RobStride/EDULITE_A3/ACTIVATE_XBOX_CONTROLLER.md

# 激活已连接的Xbox手柄

## ✅ 当前状态

您的Xbox手柄已通过蓝牙成功连接（电量31%），现在需要激活joystick接口。

## 🔧 激活步骤

请在终端中依次执行以下命令：

### 1. 重新加载joydev模块

```bash
sudo rmmod joydev
sudo modprobe joydev
```

### 2. 激活手柄（按任意按钮）

**按下Xbox手柄上的任意按钮**（如A按钮或摇杆），让系统识别它。

### 3. 验证设备

```bash
ls -l /dev/input/js*
```

应该能看到：
```
crw-rw---- 1 root input 13, 0 Jan 5 21:xx /dev/input/js0
```

## 🧪 快速测试

### 测试1：查看设备文件

```bash
# 如果看到js0，说明成功了
ls /dev/input/js0
```

### 测试2：使用ROS2 joy节点测试

```bash
cd /home/wy/RS/A3/ros2_ws
source /opt/ros/humble/setup.bash
source install/setup.bash

# 启动joy节点（使用event接口作为备选）
ros2 run joy joy_node --ros-args -p device_name:=/dev/input/js0

# 或者如果js0不存在，尝试使用event接口
# 先找出Xbox手柄的event号
cat /proc/bus/input/devices | grep -B 5 -A 5 "Xbox"
```

### 测试3：查看手柄数据

在另一个终端：
```bash
cd /home/wy/RS/A3/ros2_ws
source install/setup.bash
ros2 topic echo /joy
```

移动摇杆，应该能看到数据变化。

## 🎮 如果/dev/input/js0仍不存在

### 方案A：使用event接口

ROS2 joy节点也支持event接口。查找Xbox手柄的event设备：

```bash
# 查看所有输入设备
cat /proc/bus/input/devices

# 找到Xbox Wireless Controller对应的event号，比如event20
# 然后使用该设备
ros2 run joy joy_node --ros-args -p device_name:=/dev/input/event20 -p device_id:=0
```

### 方案B：修改launch文件使用event接口

编辑launch文件以使用event设备：

```bash
nano /home/wy/RS/A3/ros2_ws/src/el_a3_teleop/launch/simple_teleop.launch.py
```

将joy节点的参数改为：
```python
'device_name': '/dev/input/event20',  # 使用实际的event号
```

## 🚀 启动完整控制系统

手柄工作后，启动仿真系统：

```bash
cd /home/wy/RS/A3/ros2_ws
source /opt/ros/humble/setup.bash
source install/setup.bash

ros2 launch el_a3_teleop simple_teleop.launch.py
```

## 📝 一键启动脚本

我为您创建了一个启动脚本，执行：

```bash
bash /home/wy/RS/A3/scripts/start_xbox_control.sh
```

## ⚠️ 如果遇到权限问题

```bash
# 添加当前用户到input组
sudo usermod -a -G input $USER

# 注销并重新登录后生效

# 或临时修改权限
sudo chmod 666 /dev/input/js0
sudo chmod 666 /dev/input/event*
```

## 🔍 调试命令

```bash
# 查看所有输入设备
ls -la /dev/input/

# 查看设备详细信息
cat /proc/bus/input/devices

# 检查joydev模块
lsmod | grep joydev

# 查看系统日志
dmesg | tail -20
```
