RobStride/EDULITE_A3/frames_2026-01-04_16.28.14.pdf

view_frames Result

Recorded at time: 1767515294.9437292

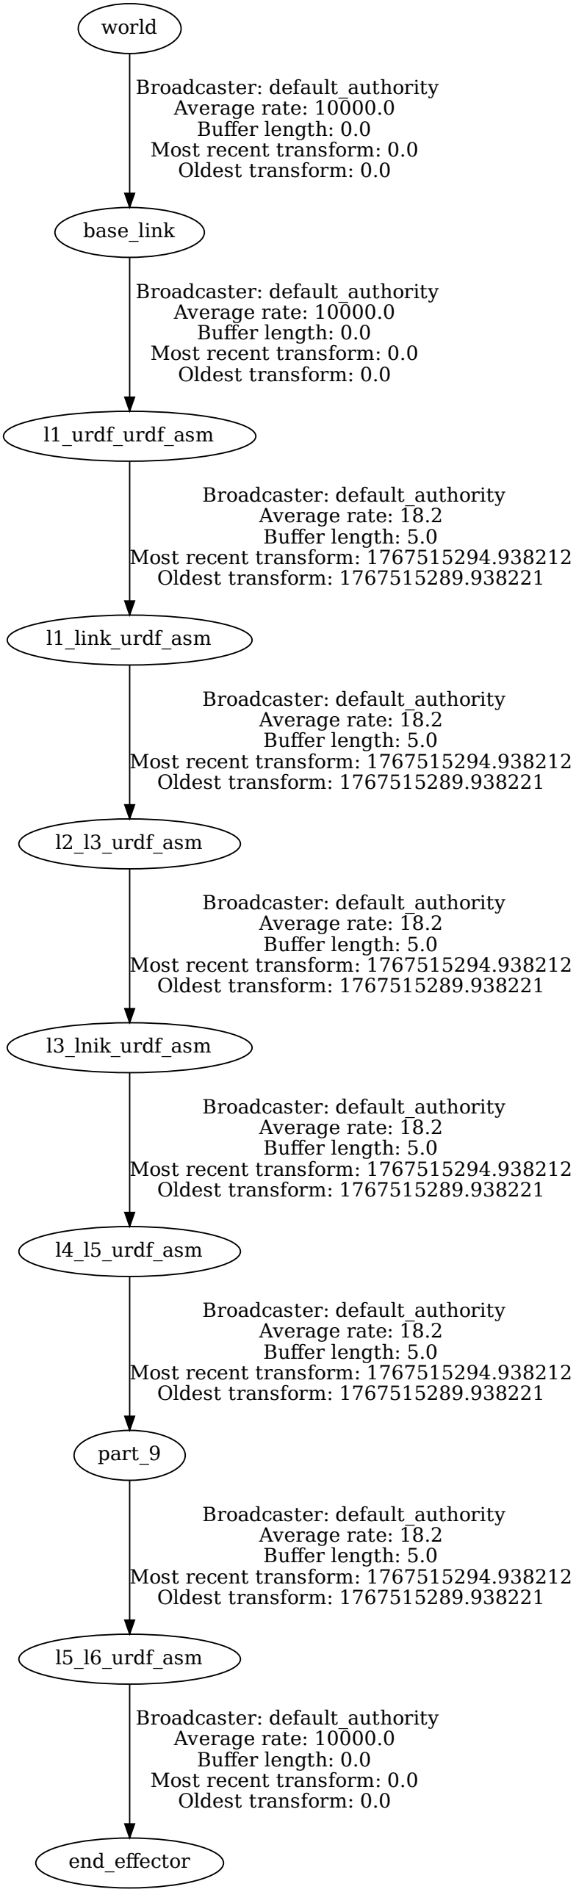
[picture p2: figure]
base_link; l1_urdf_urdf_asm; Broadcaster: default_authority Average rate: 10000.0 Buffer length: 0.0 Most recent transform: 0.0 Oldest transform: 0.0; l1_link_urdf_asm; Broadcaster: default_authority Average rate: 18.2 Buffer length: 5.0 Most recent transform: 1767515294.938212 Oldest transform: 1767515289.938221; world; l5_l6_urdf_asm; end_effector; part_9; l2_l3_urdf_asm; l3_lnik_urdf_asm; l4_l5_urdf_asm
