RobStride/EDULITE_A3/doc/image.png

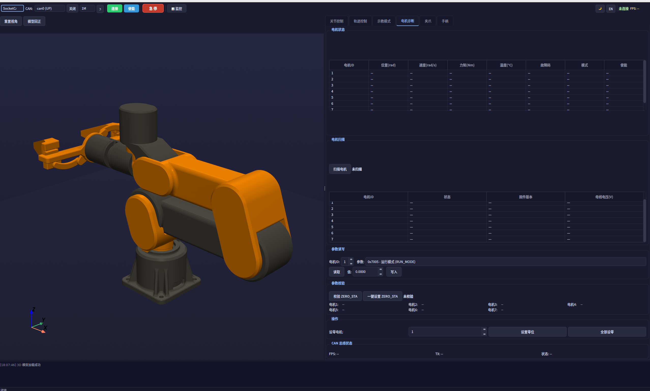
doc/image.png
