RobStride/EDULITE_A3/EL_A3_urdf/EL-A3/meshes/mainlink_back.stl

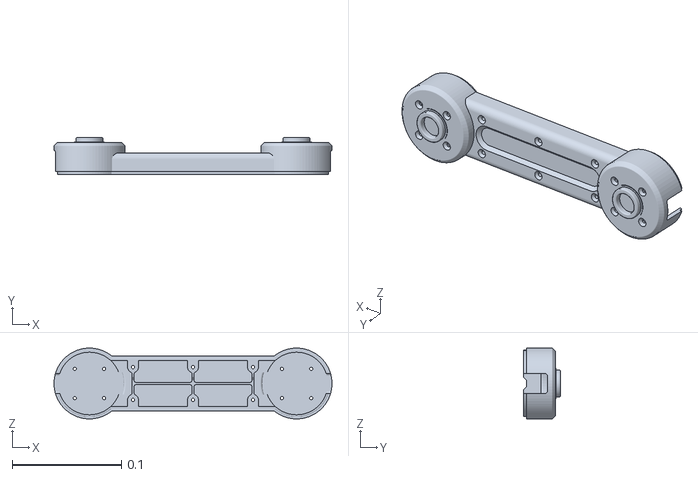
[picture p4: CAD file, 2026-02-10]
EL_A3_urdf/EL-A3/meshes/mainlink_back.stl
0.255 x 0.0338 x 0.065
