RobStride/EDULITE_A3/ros2_ws/src/el_a3_web_ui/static/urdf/meshes/mainlink_back.stl

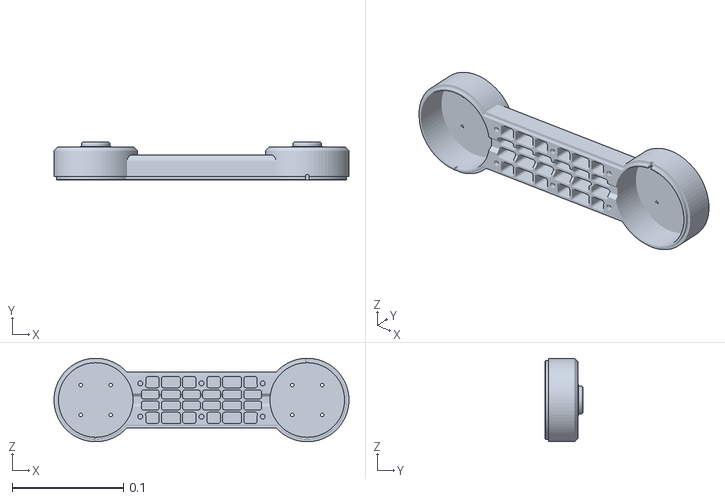
[picture p5: CAD file, 2026-02-10]
ros2_ws/src/el_a3_web_ui/static/urdf/meshes/mainlink_back.stl
0.265 x 0.0338 x 0.075
