RobStride/EDULITE_A3/EL_A3_urdf/EL-A3/meshes/mainlink_motor.stl

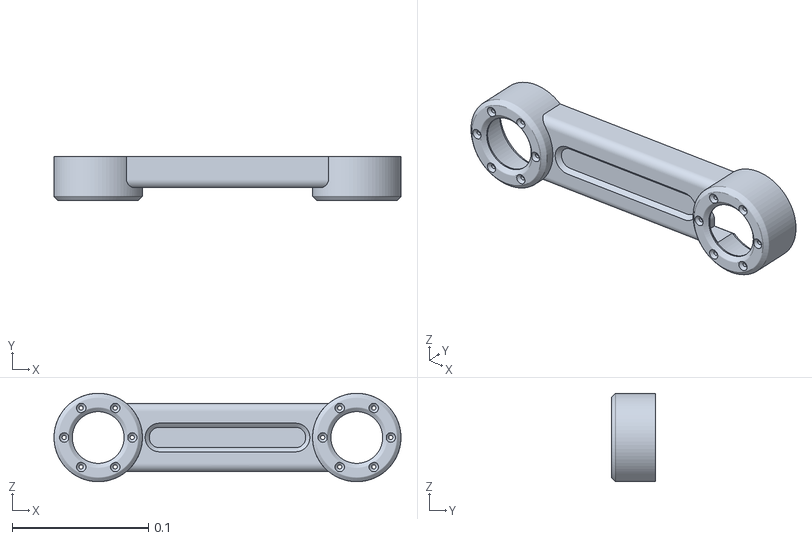
[picture p6: CAD file, 2026-02-10]
EL_A3_urdf/EL-A3/meshes/mainlink_motor.stl
0.255 x 0.0325 x 0.065
