RobStride/EDULITE_A3/EDULITE-A3/meshes/mainlink_motor.stl

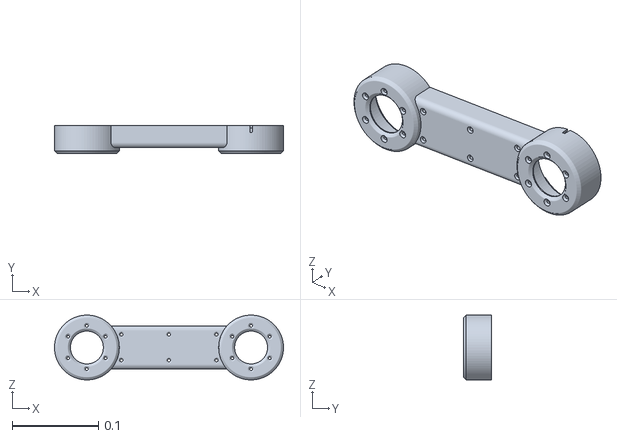
[picture p7: CAD file, 2026-02-10]
EDULITE-A3/meshes/mainlink_motor.stl
0.265 x 0.0325 x 0.075
