RobStride/EDULITE_A3/EDULITE-A3/meshes/manifold_solid_brep_39_1__2.stl

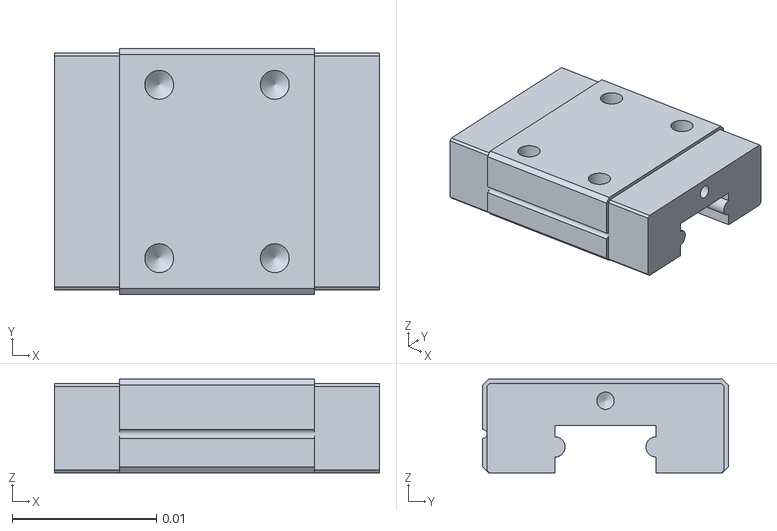
[picture p8: CAD file, 2026-02-10]
EDULITE-A3/meshes/manifold_solid_brep_39_1__2.stl
0.0225 x 0.017 x 0.0065
