RobStride/EDULITE_A3/el_a3_description/meshes/6705.stl

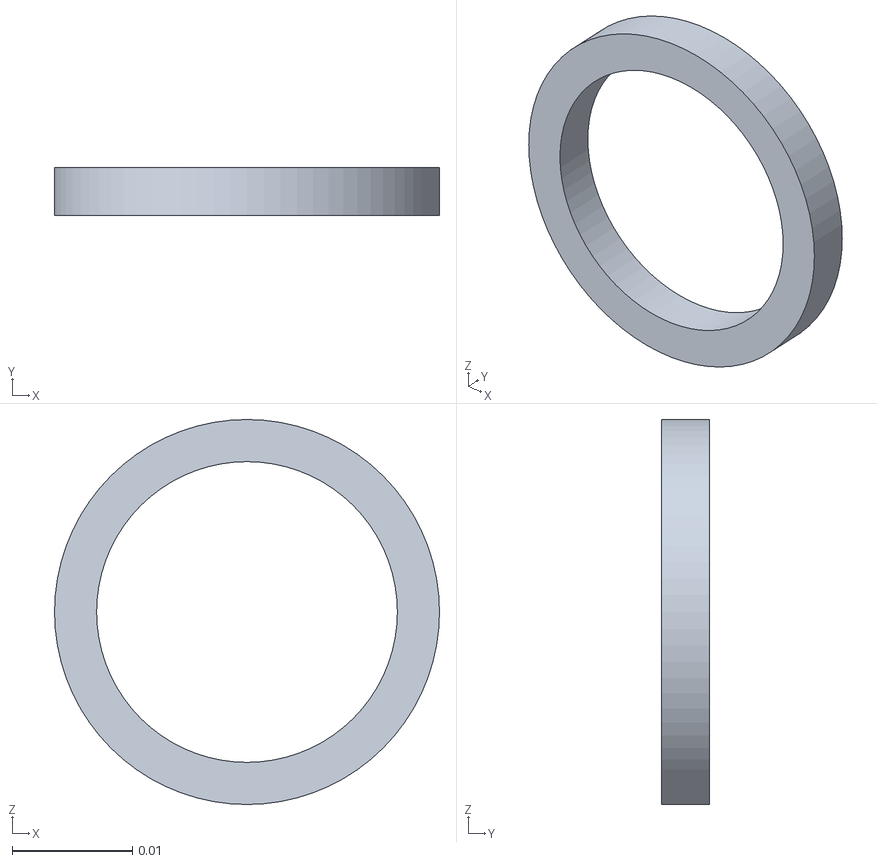
[picture p9: CAD file, 2026-02-10]
el_a3_description/meshes/6705.stl
0.032 x 0.004 x 0.032
