RobStride/EDULITE_A3/EL_A3_urdf/EL-A3/meshes/l4_l5_link_back__2.stl

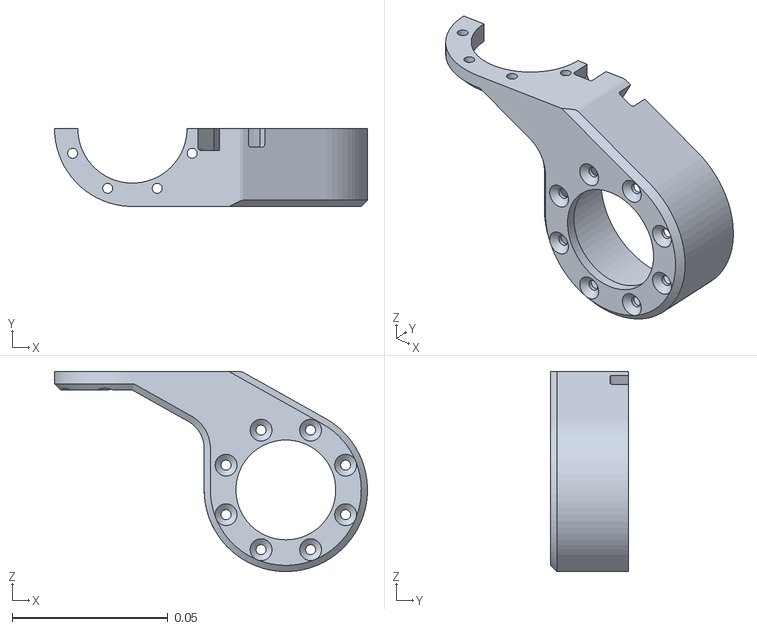
[picture p10: CAD file, 2026-02-10]
EL_A3_urdf/EL-A3/meshes/l4_l5_link_back__2.stl
0.1 x 0.025 x 0.0642
