RobStride/EDULITE_A3/ros2_ws/src/el_a3_web_ui/static/urdf/meshes/rack__30_teeth__2.stl

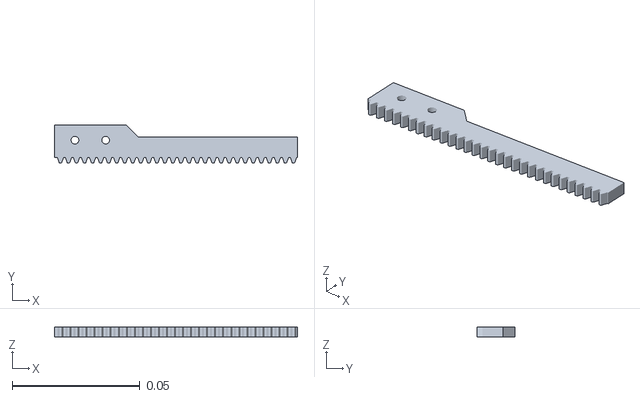
[picture p11: CAD file, 2026-02-10]
ros2_ws/src/el_a3_web_ui/static/urdf/meshes/rack__30_teeth__2.stl
0.095 x 0.015 x 0.004
