RobStride/EDULITE_A3/el_a3_description/meshes/part_9__2.stl

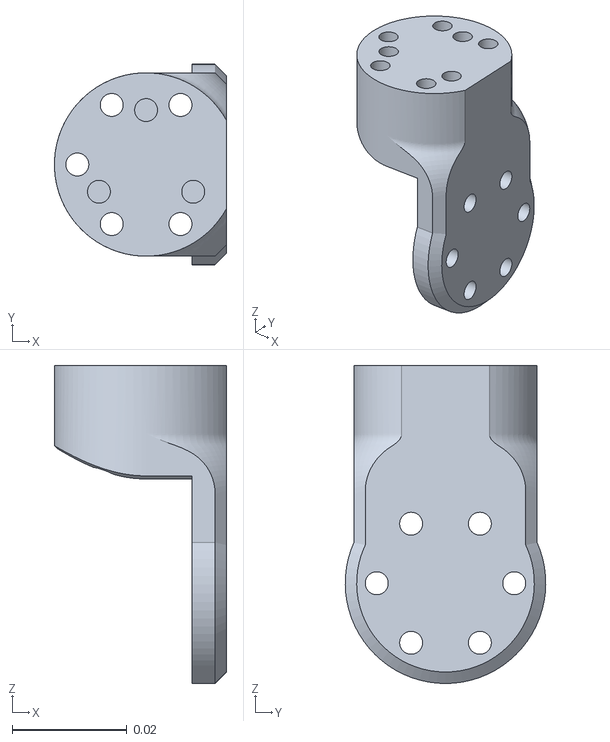
[picture p12: CAD file, 2026-02-10]
el_a3_description/meshes/part_9__2.stl
0.03 x 0.035 x 0.0555
