RobStride/EDULITE_A3/ros2_ws/src/el_a3_web_ui/static/urdf/meshes/manifold_solid_brep_40_1.stl

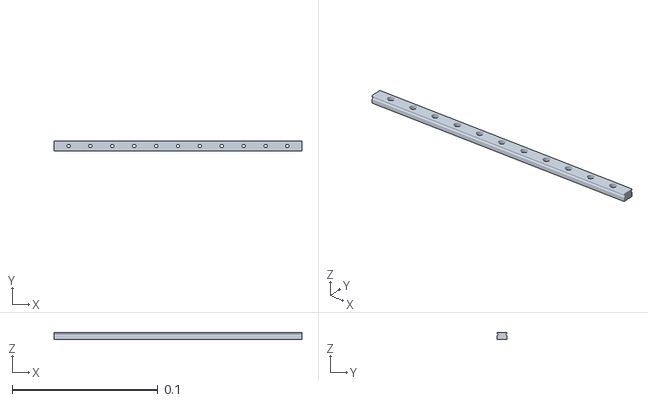
[picture p13: CAD file, 2026-02-10]
ros2_ws/src/el_a3_web_ui/static/urdf/meshes/manifold_solid_brep_40_1.stl
0.17 x 0.007 x 0.0048
