RobStride/EDULITE_A3/EDULITE-A3/meshes/part_9.stl

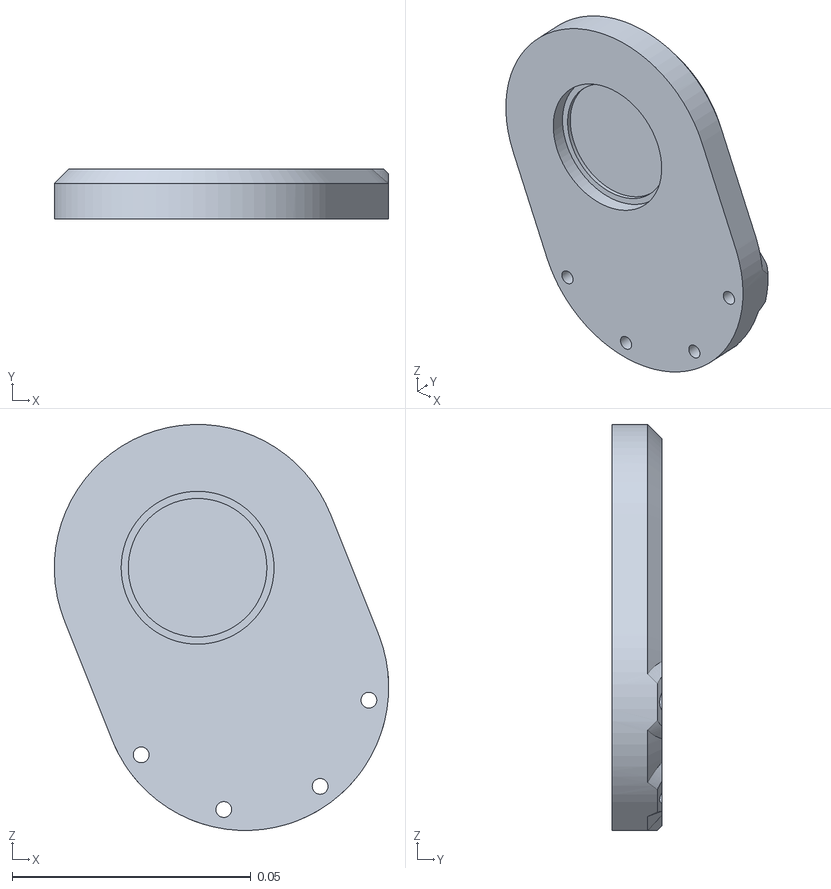
[picture p14: CAD file, 2026-02-10]
EDULITE-A3/meshes/part_9.stl
0.07 x 0.0105 x 0.085
