RobStride/EDULITE_A3/el_a3_description/meshes/small_arm_left.stl

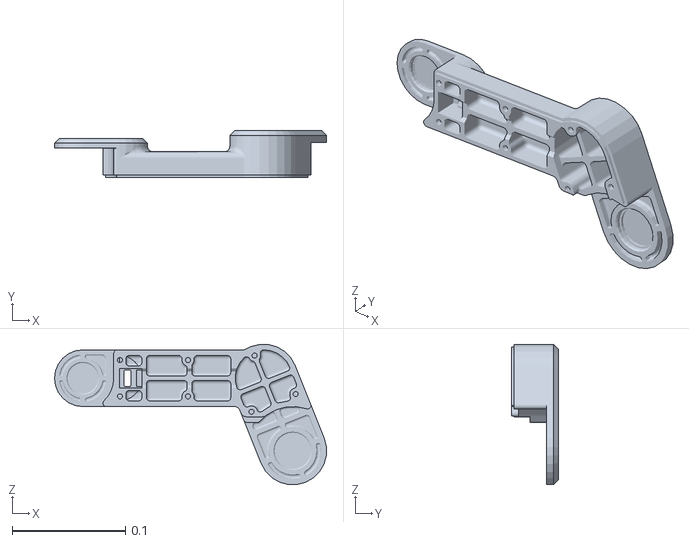
[picture p15: CAD file, 2026-02-10]
el_a3_description/meshes/small_arm_left.stl
0.24 x 0.041 x 0.124
