RobStride/EDULITE_A3/EL_A3_urdf/EL-A3/meshes/l4_link_drv.stl

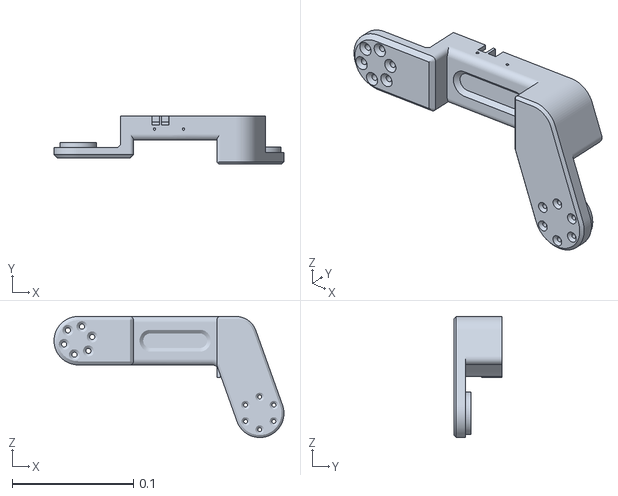
[picture p16: CAD file, 2026-02-10]
EL_A3_urdf/EL-A3/meshes/l4_link_drv.stl
0.19 x 0.04 x 0.1
