RobStride/EDULITE_A3/ros2_ws/src/el_a3_web_ui/static/urdf/meshes/el05_l5.stl

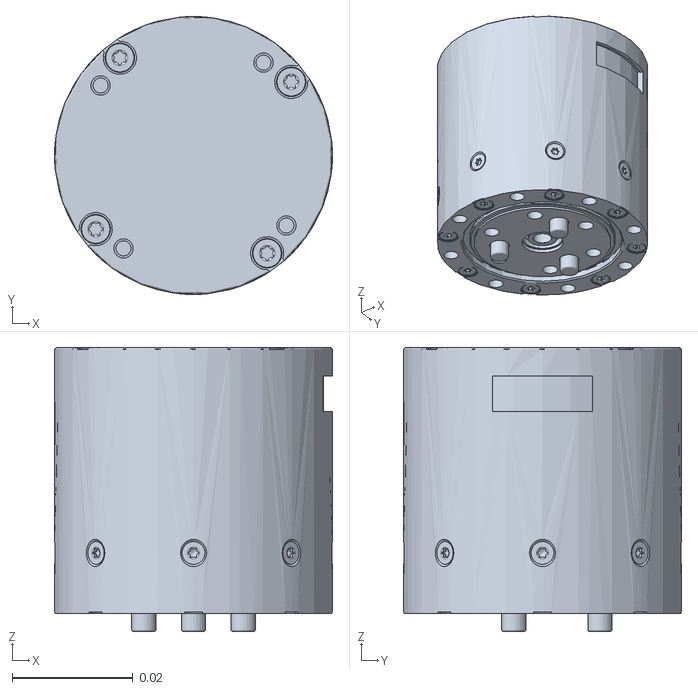
[picture p17: CAD file, 2026-02-10]
ros2_ws/src/el_a3_web_ui/static/urdf/meshes/el05_l5.stl
0.046 x 0.046 x 0.047
