RobStride/EDULITE_A3/EDULITE-A3/meshes/part_15.stl

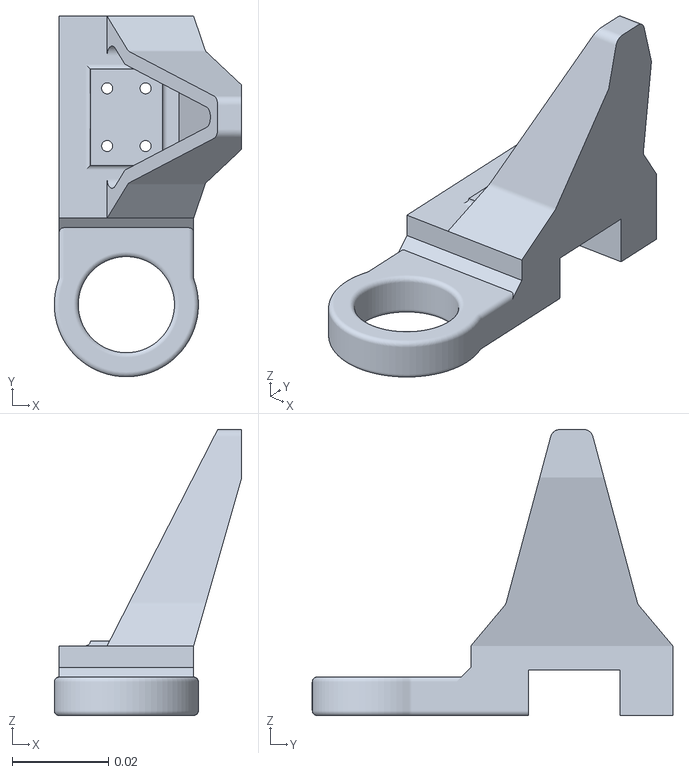
[picture p18: CAD file, 2026-02-10]
EDULITE-A3/meshes/part_15.stl
0.039 x 0.075 x 0.0595
