RobStride/EDULITE_A3/el_a3_description/meshes/l4_l5_link_back__2.stl

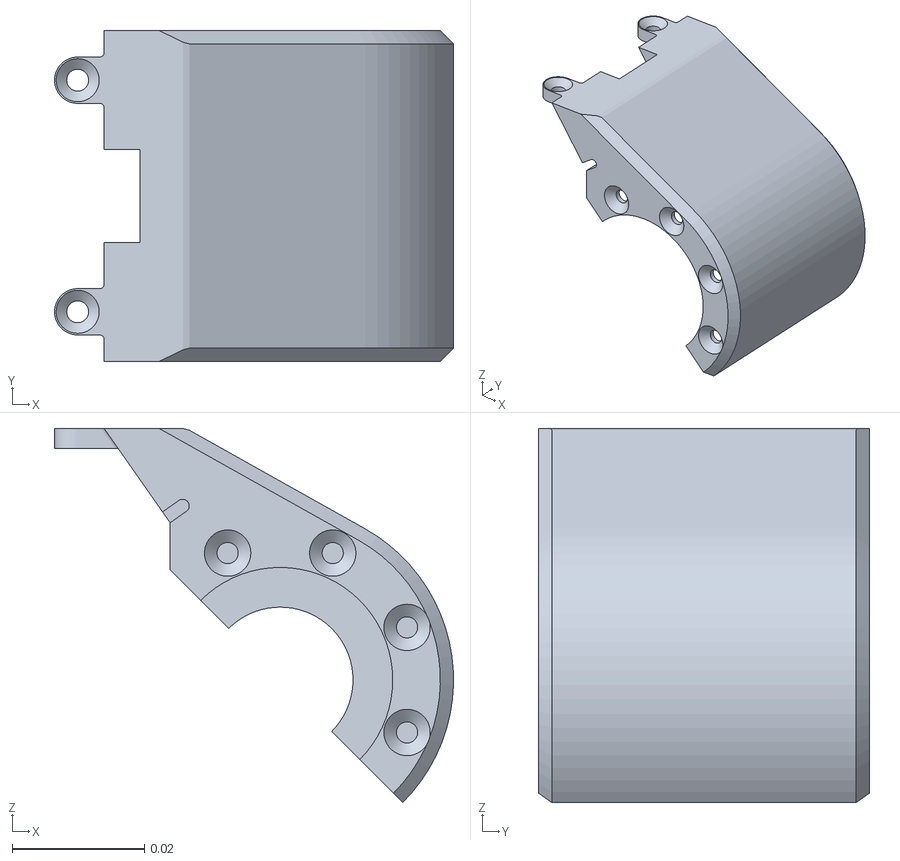
[picture p19: CAD file, 2026-02-10]
el_a3_description/meshes/l4_l5_link_back__2.stl
0.0603 x 0.05 x 0.0565
