RobStride/EDULITE_A3/EL_A3_urdf/EL-A3/meshes/l5_shake.stl

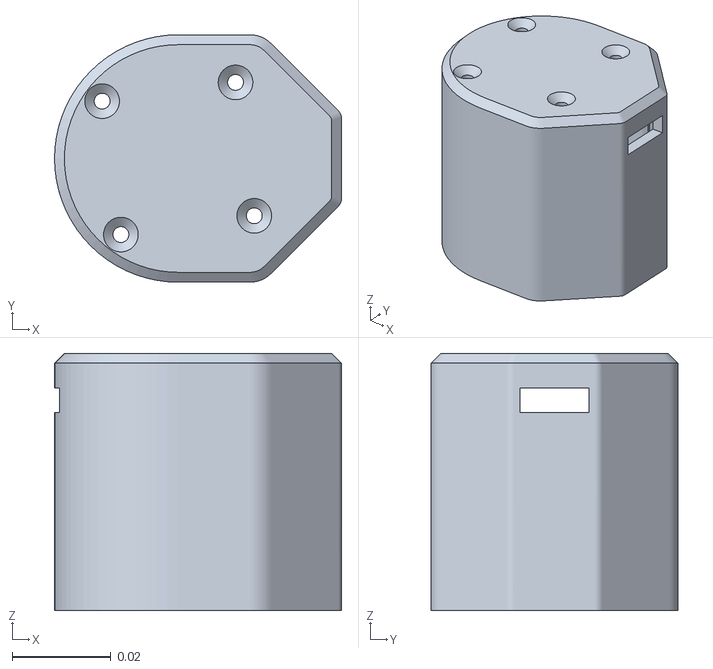
[picture p20: CAD file, 2026-02-10]
EL_A3_urdf/EL-A3/meshes/l5_shake.stl
0.058 x 0.05 x 0.052
