RobStride/EDULITE_A3/ros2_ws/src/el_a3_web_ui/static/urdf/meshes/part_4.stl

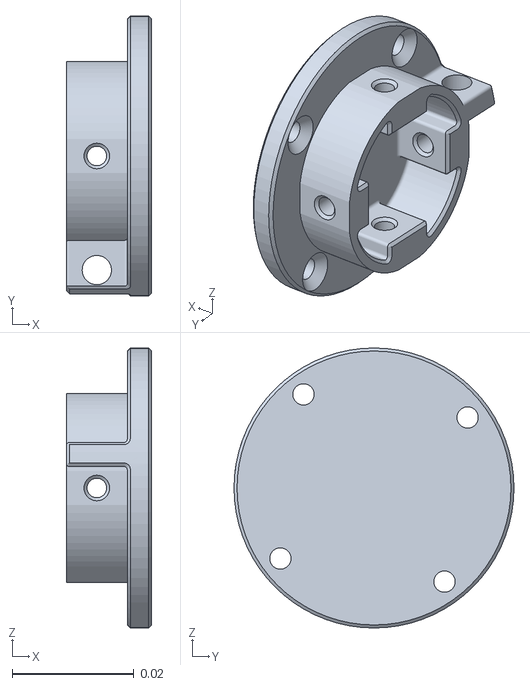
[picture p21: CAD file, 2026-02-10]
ros2_ws/src/el_a3_web_ui/static/urdf/meshes/part_4.stl
0.014 x 0.046 x 0.046
