RobStride/EDULITE_A3/el_a3_description/meshes/small_arm_right.stl

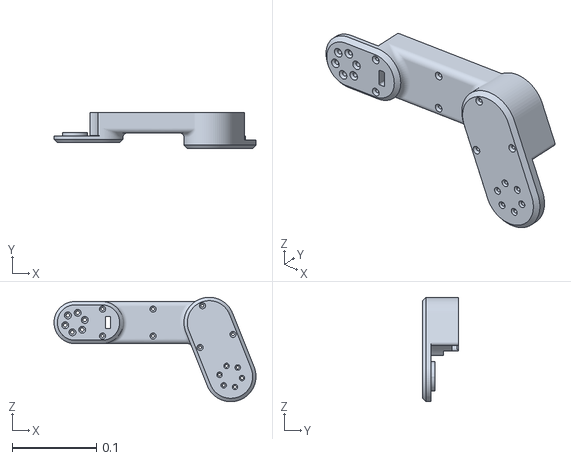
[picture p22: CAD file, 2026-02-10]
el_a3_description/meshes/small_arm_right.stl
0.24 x 0.043 x 0.124
