RobStride/EDULITE_A3/EL_A3_urdf/EL-A3/meshes/rack_str.stl

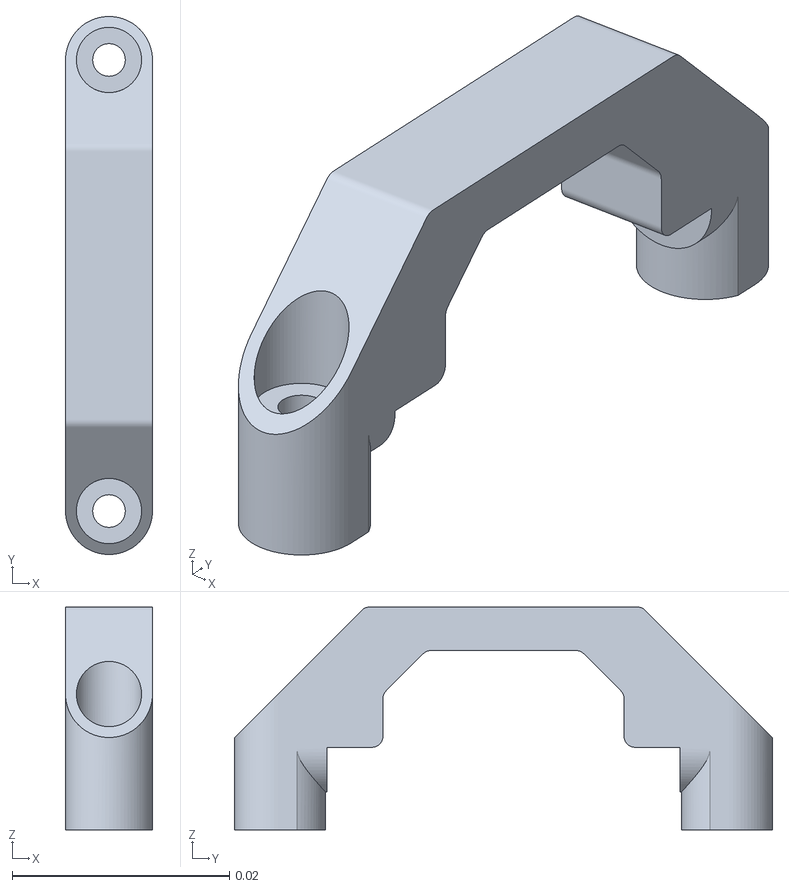
[picture p23: CAD file, 2026-02-10]
EL_A3_urdf/EL-A3/meshes/rack_str.stl
0.008 x 0.0495 x 0.0205
