RobStride/EDULITE_A3/EDULITE-A3/meshes/el05.stl

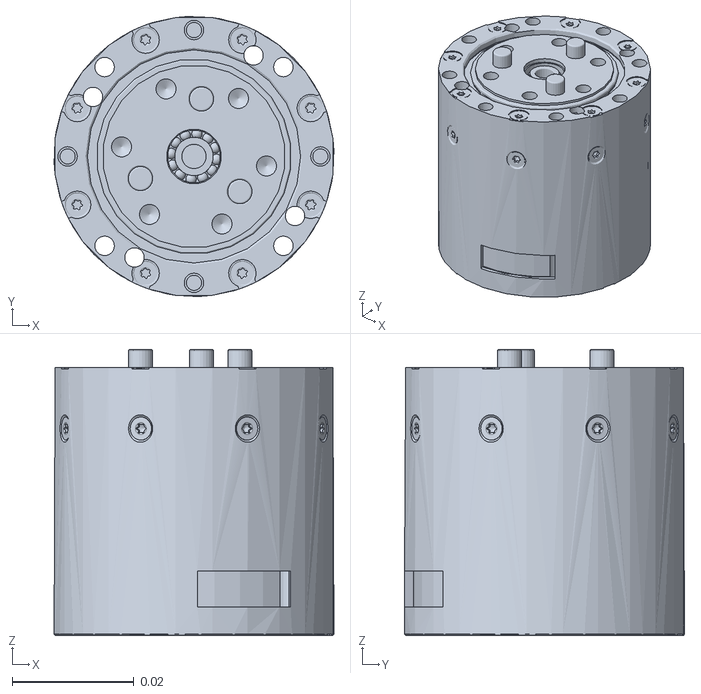
[picture p24: CAD file, 2026-02-10]
EDULITE-A3/meshes/el05.stl
0.046 x 0.046 x 0.047
