RobStride/EDULITE_A3/el_a3_description/meshes/spur_gear__14_teeth.stl

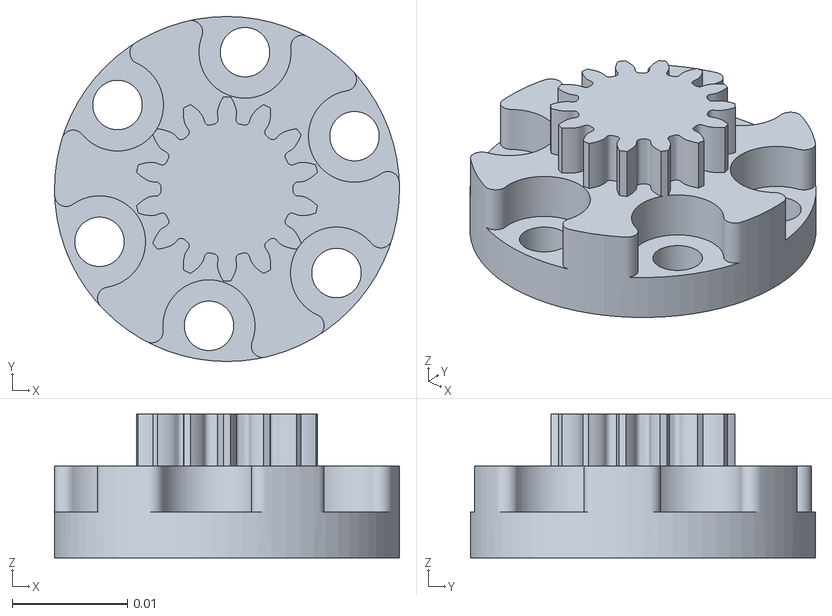
[picture p25: CAD file, 2026-02-10]
el_a3_description/meshes/spur_gear__14_teeth.stl
0.03 x 0.03 x 0.0125
