RobStride/EDULITE_A3/el_a3_description/meshes/part_8.stl

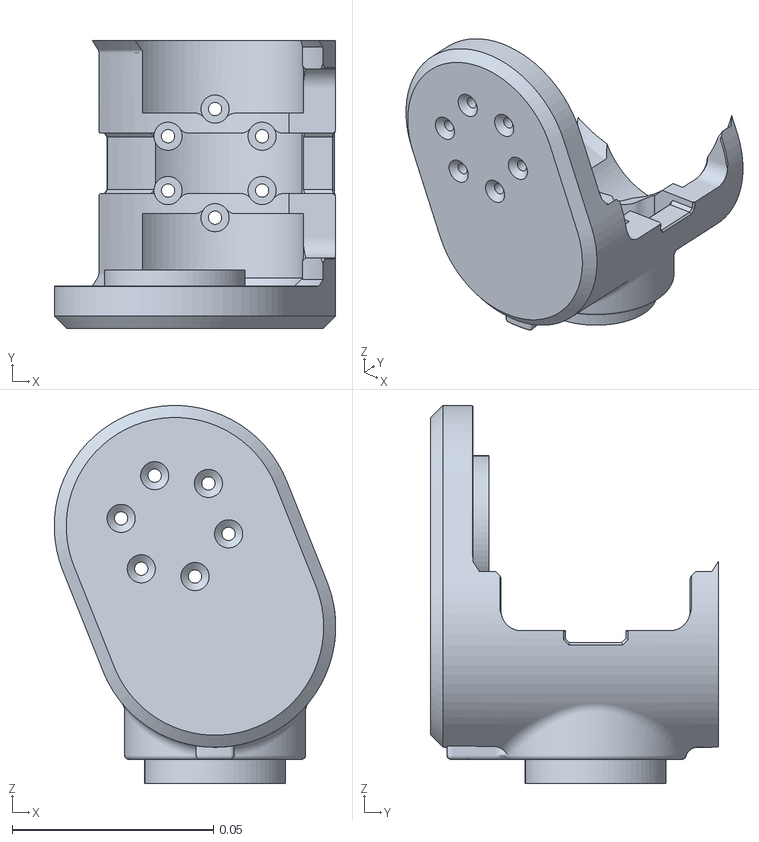
[picture p26: CAD file, 2026-02-10]
el_a3_description/meshes/part_8.stl
0.07 x 0.0715 x 0.094
