RobStride/EDULITE_A3/EDULITE-A3/meshes/rack_base.stl

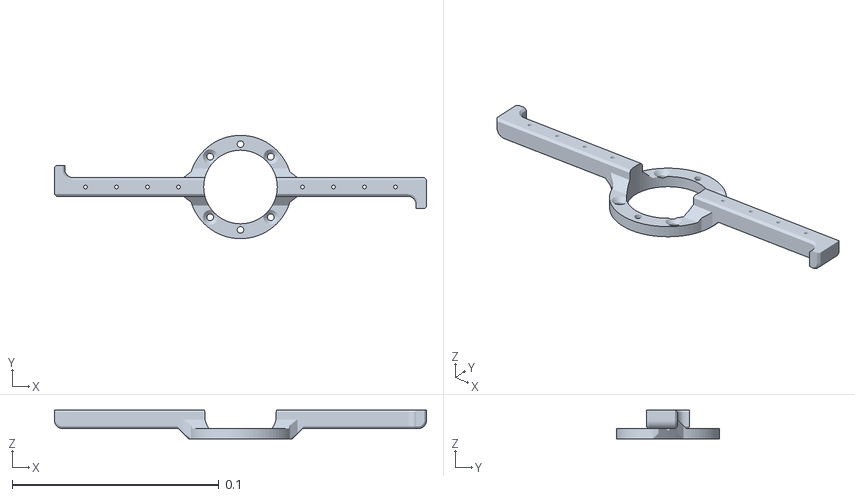
[picture p27: CAD file, 2026-02-10]
EDULITE-A3/meshes/rack_base.stl
0.18 x 0.05 x 0.014
