RobStride/EDULITE_A3/EL_A3_urdf/EL-A3/meshes/l1_link_drv.stl

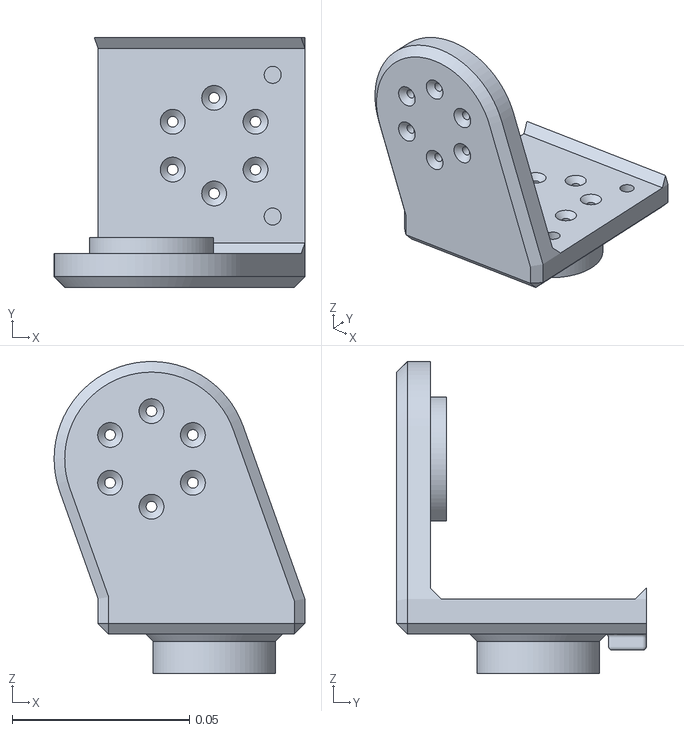
[picture p28: CAD file, 2026-02-10]
EL_A3_urdf/EL-A3/meshes/l1_link_drv.stl
0.0708 x 0.0705 x 0.0881
