RobStride/EDULITE_A3/ros2_ws/src/el_a3_web_ui/static/urdf/meshes/l4_l5_link_back.stl

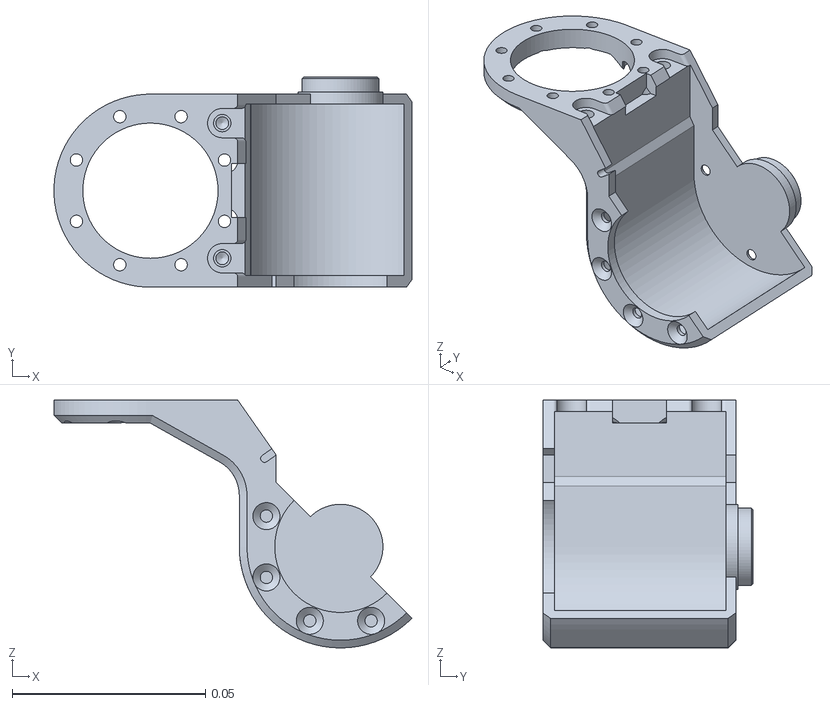
[picture p29: CAD file, 2026-02-10]
ros2_ws/src/el_a3_web_ui/static/urdf/meshes/l4_l5_link_back.stl
0.0927 x 0.0545 x 0.0642
