RobStride/EDULITE_A3/el_a3_description/meshes/part_3.stl

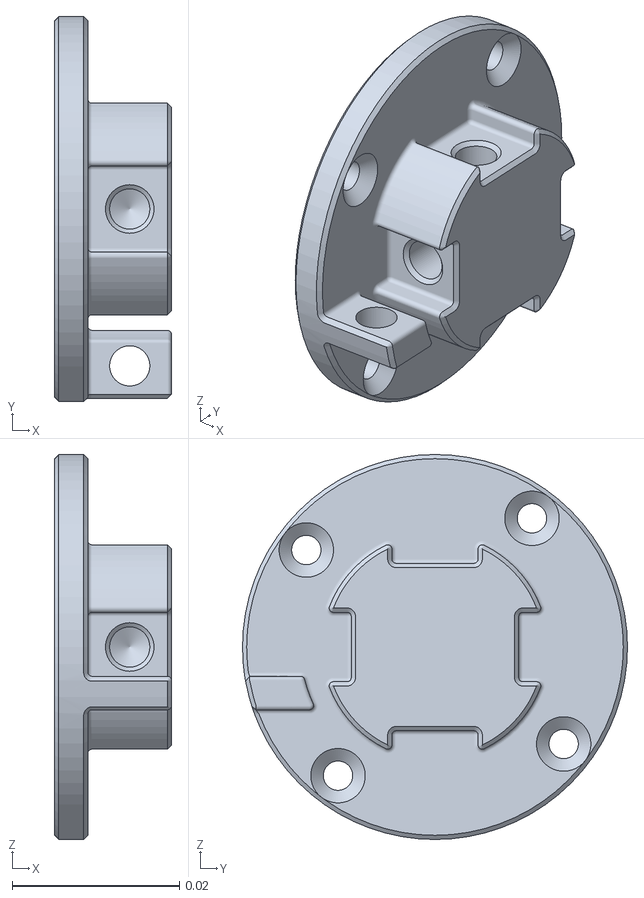
[picture p30: CAD file, 2026-02-10]
el_a3_description/meshes/part_3.stl
0.014 x 0.046 x 0.046
