RobStride/EDULITE_A3/EL_A3_urdf/EL-A3/meshes/l1_link_stop.stl

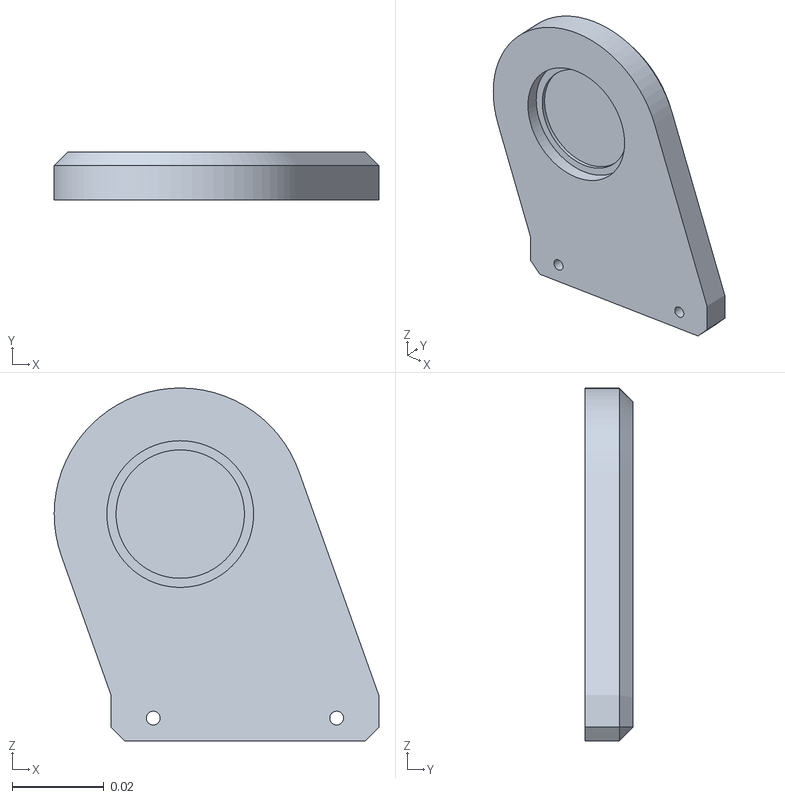
[picture p31: CAD file, 2026-02-10]
EL_A3_urdf/EL-A3/meshes/l1_link_stop.stl
0.0708 x 0.0105 x 0.077
