RobStride/EDULITE_A3/ros2_ws/src/el_a3_web_ui/static/urdf/meshes/l5_shake.stl

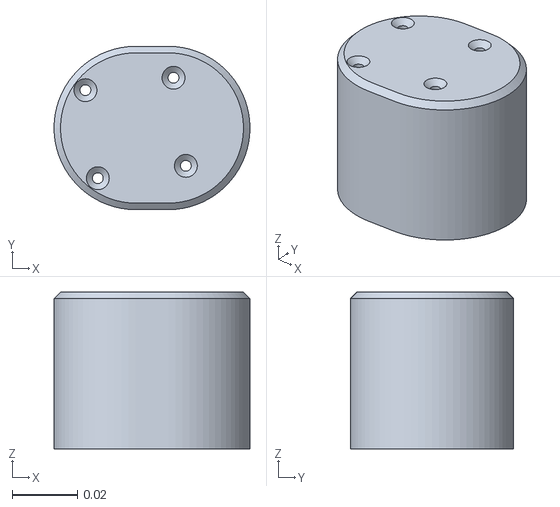
[picture p32: CAD file, 2026-02-10]
ros2_ws/src/el_a3_web_ui/static/urdf/meshes/l5_shake.stl
0.06 x 0.05 x 0.048
