RobStride/EDULITE_A3/EL_A3_urdf/EL-A3/meshes/l1_base.stl

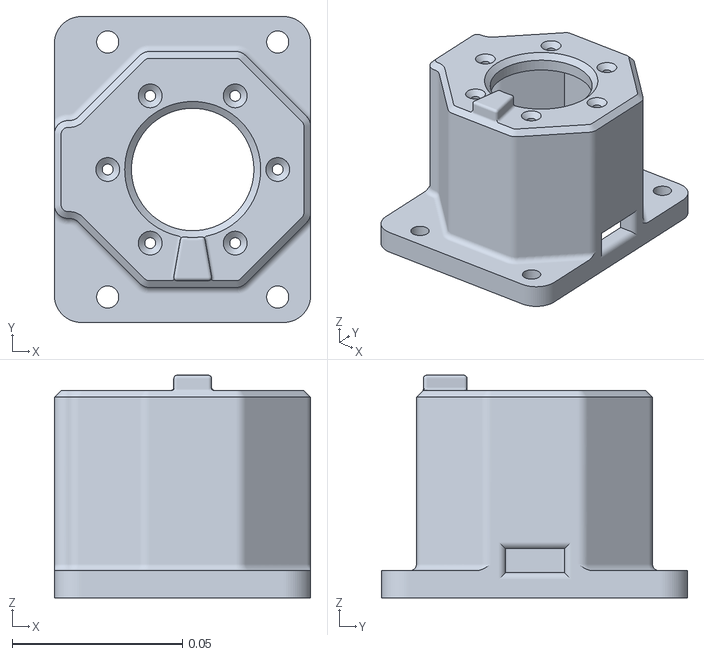
[picture p33: CAD file, 2026-02-10]
EL_A3_urdf/EL-A3/meshes/l1_base.stl
0.0754 x 0.09 x 0.0655
