RobStride/EDULITE_A3/EDULITE-A3/meshes/part_10.stl

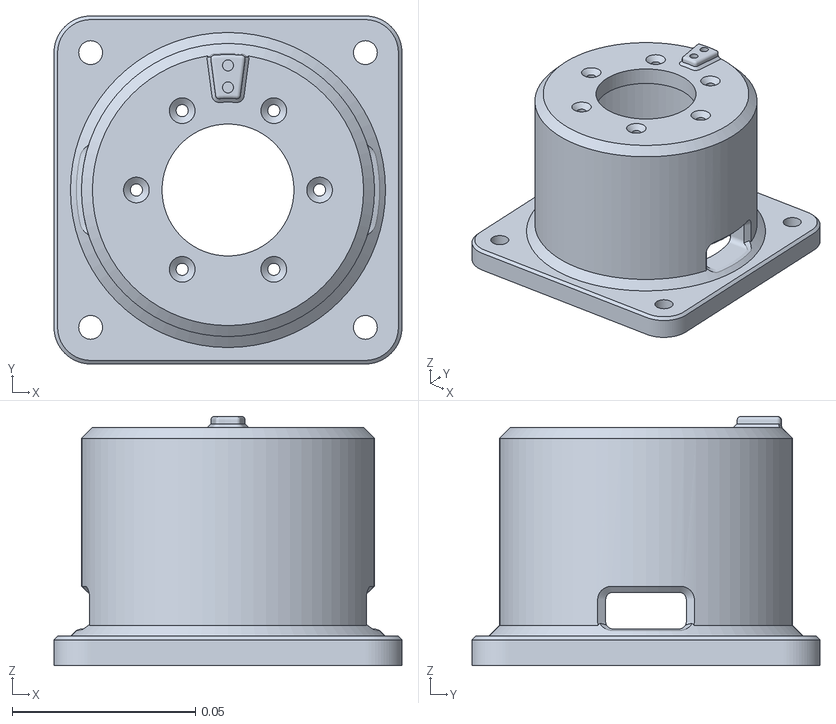
[picture p34: CAD file, 2026-02-10]
EDULITE-A3/meshes/part_10.stl
0.095 x 0.095 x 0.068
