RobStride/EDULITE_A3/EL_A3_urdf/EL-A3/meshes/part_9.stl

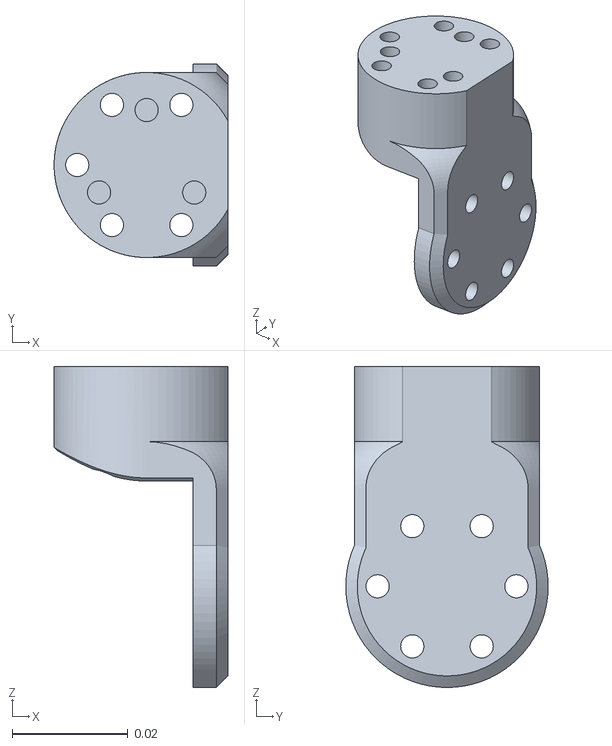
[picture p35: CAD file, 2026-02-10]
EL_A3_urdf/EL-A3/meshes/part_9.stl
0.03 x 0.035 x 0.0555
