RobStride/EDULITE_A3/EL_A3_urdf/EL-A3/meshes/l4_l5_link_back.stl

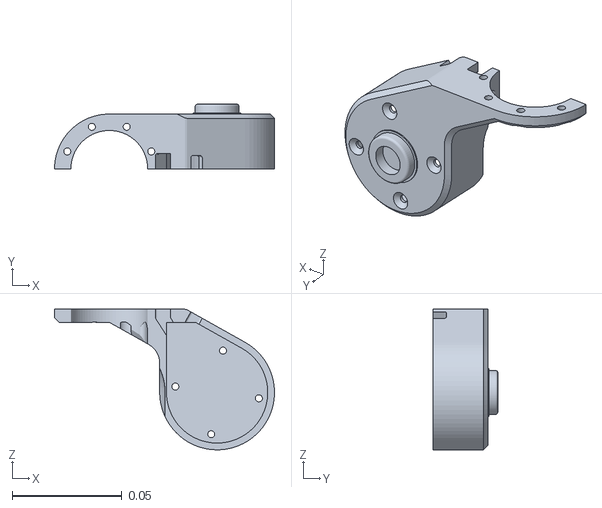
[picture p36: CAD file, 2026-02-10]
EL_A3_urdf/EL-A3/meshes/l4_l5_link_back.stl
0.1 x 0.0295 x 0.0642
