RobStride/EDULITE_A3/EL_A3_urdf/EL-A3/meshes/part_1.stl

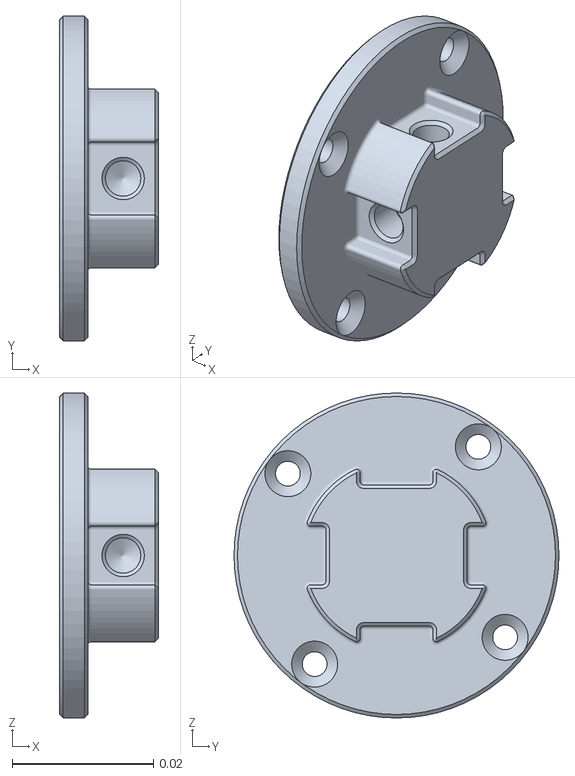
[picture p37: CAD file, 2026-02-10]
EL_A3_urdf/EL-A3/meshes/part_1.stl
0.014 x 0.046 x 0.046
