RobStride/EDULITE_A3/EL_A3_urdf/EL-A3/meshes/l2_stop.stl

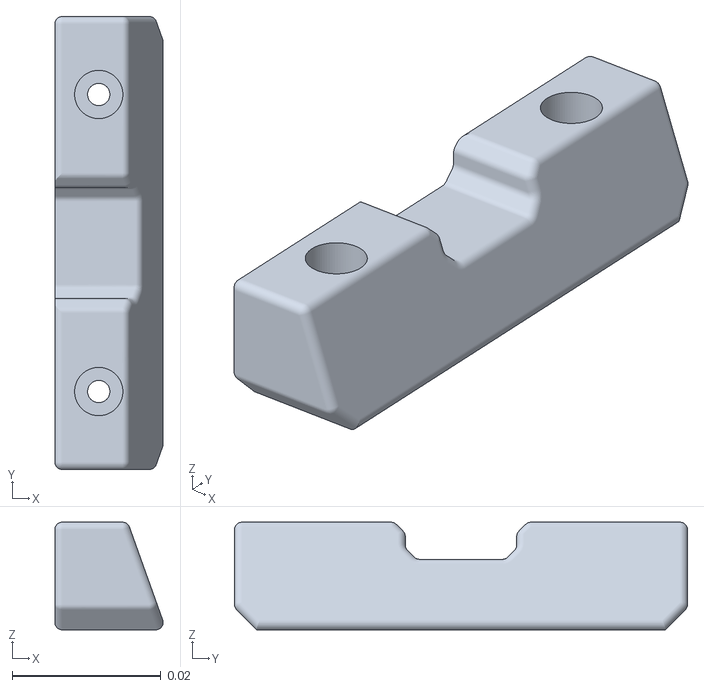
[picture p39: CAD file, 2026-02-10]
EL_A3_urdf/EL-A3/meshes/l2_stop.stl
0.0146 x 0.061 x 0.0145
