RobStride/EDULITE_A3/(list of files, cad)

Other CAD files:
EDULITE-A3/meshes/manifold_solid_brep_39_1.stl
EDULITE-A3/meshes/hand_r.stl
EL_A3_urdf/EL-A3/meshes/6705.stl
ros2_ws/src/el_a3_web_ui/static/urdf/meshes/hand_r.stl
EDULITE-A3/meshes/6705__2.stl
EL_A3_urdf/EL-A3/meshes/el05_l5.stl
ros2_ws/src/el_a3_web_ui/static/urdf/meshes/rack__30_teeth.stl
EDULITE-A3/meshes/el05_l4.stl
ros2_ws/src/el_a3_web_ui/static/urdf/meshes/el05_l4.stl
el_a3_description/meshes/manifold_solid_brep_39_1.stl
EL_A3_urdf/EL-A3/meshes/manifold_solid_brep_39_1.stl
el_a3_description/meshes/el05_l4.stl
EL_A3_urdf/EL-A3/meshes/hand_r.stl
EL_A3_urdf/EL-A3/meshes/el05_l4.stl
EDULITE-A3/meshes/rack__30_teeth.stl
EL_A3_urdf/EL-A3/meshes/rack__30_teeth.stl
el_a3_description/meshes/hand_r.stl
ros2_ws/src/el_a3_web_ui/static/urdf/meshes/manifold_solid_brep_39_1.stl
ros2_ws/src/el_a3_web_ui/static/urdf/meshes/6705__2.stl
el_a3_description/meshes/6705__2.stl
EL_A3_urdf/EL-A3/meshes/6705__2.stl
el_a3_description/meshes/rack__30_teeth.stl
EL_A3_urdf/EL-A3/meshes/l4_link_back.stl
