RobStride/EDULITE_A3/(commit log)

2026-02-10 feat: initial release
    [6705.stl, 6705__2.stl, EDULITE-A3.urdf, EL-A3.urdf, el05.stl, el05_l4.stl, el05_l5.stl, el_a3.urdf]
2026-05-09 fix gravity_torques
    [el_a3_ros2_control.xacro]
2026-08-03 update the information of the motorsudio
    [el_a3_ros2_control.xacro, joint_limits.yaml]
